PixelSergey/Telegraph/(threads)

Thread 1 (2022-12-30):

Unable to compile on ESP8266

lukcerny, 2022-12-30:
Hello, trying to compile your code for ESP8266, but getting error `Compilation error: 'ThingerESP8266' does not name a type`

Any idea what can be wrong ? Many thanks in advance for your help!

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
