PixelSergey/Telegraph/telegraph.ino

/**    
 *  Telegraph's main program file.
 *  Copyright (C) 2020 PixelSergey
 *
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
 *  You should have received a copy of the GNU General Public License
 *  along with this program.  If not, see <https://www.gnu.org/licenses/>.
 */

// The preferences file is automatically included here by the Arduino IDE.

// System variables
ThingerESP8266 thing(USERNAME, DEVICE_ID, DEVICE_CREDENTIAL);
char recvname[9]; // The name of the receiver
long dt; // The time difference between both NodeMCUs

// Input lists
std::vector<unsigned long> in_millis;
std::vector<int> in_command;

void output(){
    static int last_button = -1;
    static int current_button = -1;
    static unsigned long last_millis = millis();
    int button = digitalRead(BUTTON);
    int state = digitalRead(SWITCH);

    if(state == HIGH){  // If sending
        analogWrite(LED_RED, 1023);
    }else{
        analogWrite(LED_RED, 820);
    }
    
    if(button != last_button){
        last_millis = millis();
    }
    
    if(millis() - last_millis > 7){
        if(button != current_button){
            current_button = button;
            if(button == LOW){
                analogWrite(LED_GRN, 0);
                tone(SPEAKER, PITCH);
            }else{
                analogWrite(LED_GRN, 1023);
                noTone(SPEAKER);
            }
            if(state == HIGH){
                pson payload;
                payload["command"] = button;
                payload["millis"] = millis();
                //Serial.println(button);
                thing.call_device(recvname, "command", payload);
            }
        }
    }
    
    last_button = button;
}

void input(){
    if(!in_command.empty() && !in_millis.empty()){
        if(millis() > in_millis.front() + dt + 1000){
            // The button emits a LOW voltage when pressed due to the INPUT_PULLUP mode
            if(in_command.front() == LOW){
                analogWrite(LED_BLU, 0);
                tone(SPEAKER, PITCH);
                //Serial.println("Activated");
            }else{
                analogWrite(LED_BLU, 1023);
                noTone(SPEAKER);
                //Serial.println("De-activated");
            }
            in_command.erase(in_command.begin());
            in_millis.erase(in_millis.begin());
        }
    }
}

void setup(){
    //Serial.begin(9600);
    pinMode(BUTTON, INPUT_PULLUP);
    pinMode(SWITCH, INPUT_PULLUP);
    pinMode(SPEAKER, OUTPUT);
    pinMode(LED_RED, OUTPUT);
    pinMode(LED_GRN, OUTPUT);
    pinMode(LED_BLU, OUTPUT);
    // Due to the RGB led having a common anode, analog 0 turns
    // an LED fully on and analog 1023 turns it fully off
    analogWrite(LED_RED, 0);
    analogWrite(LED_GRN, 1023);
    analogWrite(LED_BLU, 1023);

    // The WiFiManager class is rather heavy. This creates a scope for the variable,
    // which is destroyed when it properly sets up the WiFi connection
    {
        WiFiManager wifiManager;
        wifiManager.autoConnect("Telegraph");
        thing.add_wifi(WiFi.SSID().c_str(), WiFi.psk().c_str());
    }

    // The most cursed and hacky line of code you will ever see
    // Converts NodeMCU1 <-> NodeMCU0 to find out the recipient's name
    // If you can figure out how this works, good job! Have a biscuit.
    sprintf(recvname, "NodeMCU%d", !((int)DEVICE_ID[7]-48));
    
    thing["command"] << [](pson& in){
        in_command.push_back((int) in["command"]);
        //Serial.printf("Command: %d\n", in_command.front());
        in_millis.push_back((unsigned long) in["millis"]);
        //Serial.printf("Millis: %d\n", in_millis.front());
    };
    thing["timesync"] << [](pson& in){
        dt = millis() - (unsigned long) in["millis"];
        //Serial.printf("Calculated dt = %d", dt);
        pson data;
        data["dt"] = -dt;
        thing.call_device(recvname, "timeresponse", data);
    };
    thing["timeresponse"] << [](pson& in){
        dt = (long) in["dt"];
        //Serial.printf("Received dt = %d", dt);
    };

    // Attempt to call the other NodeMCU right off the bat.
    // The first one to boot will fail, the second will succeed.
    thing.handle();
    pson data;
    data["millis"] = millis();
    thing.call_device(recvname, "timesync", data);
    analogWrite(LED_RED, 1023);
}

void loop(){
    thing.handle();
    output();
    input();
}
