PixelSergey/Telegraph/(commit log)

2020-03-03 Add RGB LED light
2020-03-07 Create signal that is sent between devices to stream
2020-04-28 Greatly simplify and refactor code
    I realised that I could change approaches to the problem entirely.
    The current approach requires me to manually detect when the button
    gets pressed and released, along with a streaming/receiving mode.
    The current approach also tries to constantly update the receiver's
    data in a way similar to streaming. The ESP8266 module is not fast
    enough for this.
    This approach uses a lot of resources and variables, and is generally
    confusing.
    The new approach uses Arduino's interrupt feature. This automatically
    sends an update to the receiver whenever the BUTTON pin's state changes.
    Streaming/receiving mode can be re-added later if needed.
    [telegraph.ino]
2020-04-29 Implement bidirectional communication using the interrupt system
    Running call_device from inside the interrupt took too many
    resources, so it had to be moved elsewhere.
    The ICACHE_RAM_ATTR attibute was added to the interrupt function
    to avoid crashing.
    The two interrupt functions were merged into one after realising
    that it was impossible to use two interrupts on one pin.
    The current solution is still rather slow and unusable for morse
    communication.
    [telegraph.ino]
2020-04-29 Improve timing system, which is still broken
    I don't think it is possible to make one NodeMCU call another
    in such a way that the information would arrive properly.
    Another method is probably required.
    [telegraph.ino]
2020-04-30 Implement NTP for signal time synchronisation
    Unfortunately, the current NTP library only receives the UNIX time
    (for some reason?), so it isn't precise enough to communicate in
    real time.
2020-04-30 Change NTP synchronisation to millis() synchronisation
    It finally works. <3
2020-04-30 Add schematic diagrams
2020-05-01 Remove useless interrupt function and organise code
    The interruption of the main code was causing problems, as
    - There is no certain way to transfer data from interrupt to loop
    - There is no easy way to debounce the interrupt function.
    As such, I replaced the interrupt function with a simple output()
    function called from the loop that uses code from the Debounce
    tutorial (can't believe I ignored that method)
    [telegraph.ino]
2020-05-06 Comment out debugging Serial prints
    Saves a minimal amount of power
2020-05-07 Add mute switch and modify pinout
2020-05-07 Update schematic diagrams for new pinout
